TichyTech/Quadcopter/docs/AP7366_grid.jpg

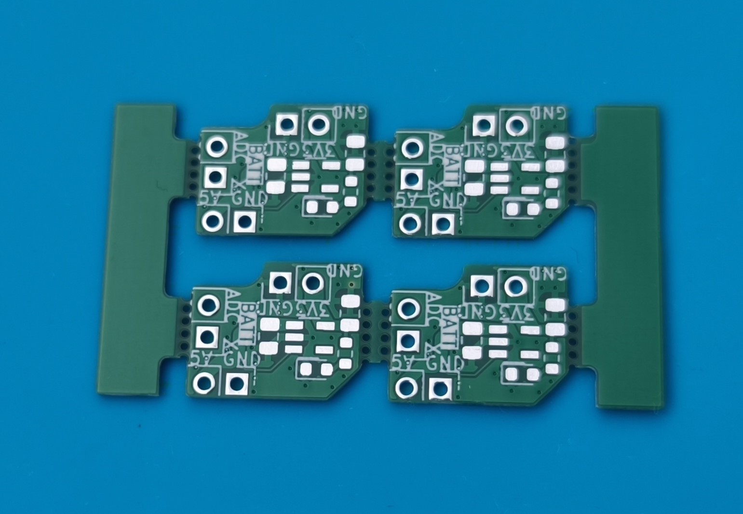
docs/AP7366_grid.jpg
