TichyTech/Quadcopter/docs/CADscreen_inside.png

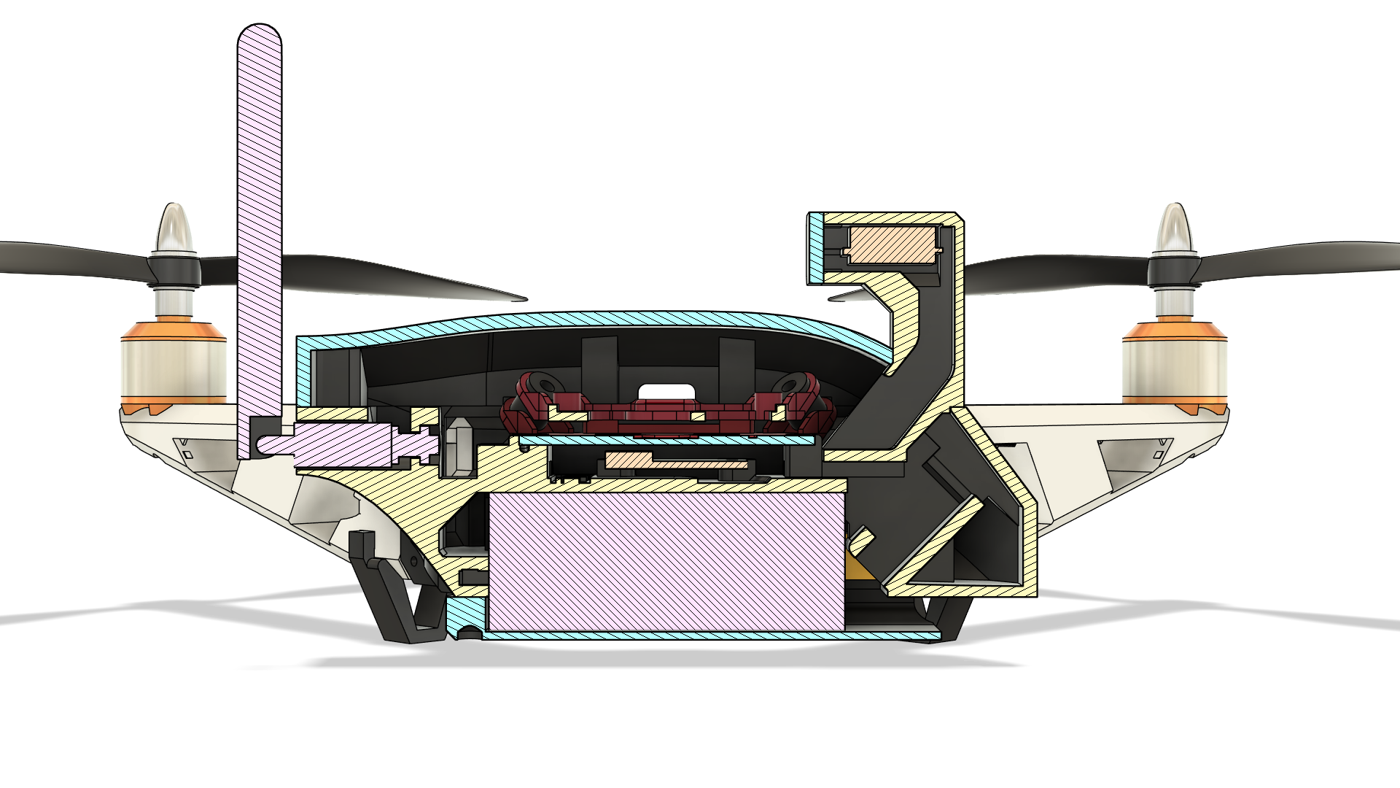
docs/CADscreen_inside.png
