TichyTech/Quadcopter/docs/FC_PCB2.jpg

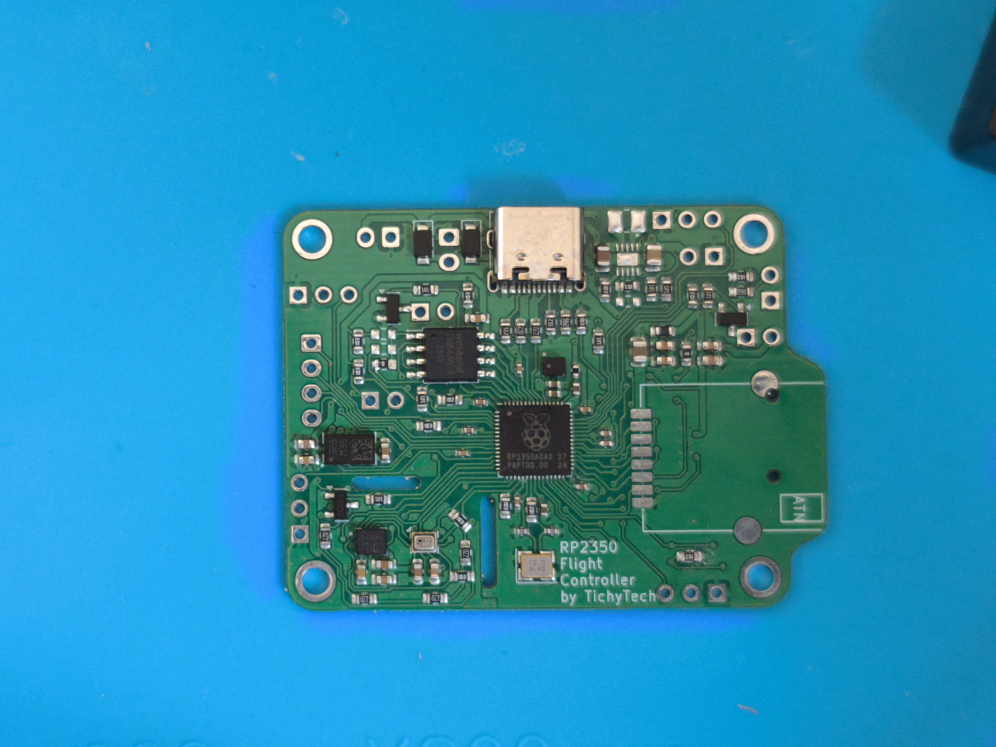
docs/FC_PCB2.jpg
