TichyTech/Quadcopter/RemoteController/src/config.h

#define PRINT_COMMANDS 0
#define DEBUG 0
#define STATE2SERIAL 1
#define HUMAN_READABLE 0  // human readable STATE2SERIAL

#define PRINT_MIN_DELAY 0

#define POT_PIN A0

#define JOYLB_PIN A1
#define JOYLX_PIN A2
#define JOYLY_PIN A3

#define JOYRX_PIN A6
#define JOYRY_PIN A7

#define BUTTON_R_PIN 2
#define BUTTON_L_PIN 3
#define SWITCH_PIN 4

#define LED1_PIN 5
#define LED2_PIN 6
#define LED3_PIN 7
#define WSLED_PIN 8
