TichyTech/Quadcopter/FlightController/include/definitions.h

#ifndef DEFS_H
#define DEFS_H

#include <BasicLinearAlgebra.h>
using namespace BLA;

// helpful commands
// #define NOP __asm__("nop");  // 0.0108 us (at pico base frequency)

/**
 * The signum function sgn(x) = -1 if x < 0, else 1
 */
template <typename T>
inline int sgn(T x){
  return x < 0 ? -1 : 1;
}

inline float max(float a, float b){
  return (a < b ? b : a);
}

// helpful constants
#define PI_F 3.14159265359f
#define TO_DEG 57.29578f
#define TO_RAD 0.01745329251f

// helpful types
using Vector3 = Matrix<3>;
using Vector4 = Matrix<4>;
using Matrix3 = Matrix<3, 3>;
using Matrix4 = Matrix<4, 4>;

const Eye<3, 3> I_3;
const Eye<4, 4> I_4;
const Eye<6, 6> I_6;
const Eye<7, 7> I_7;
const Eye<10, 10> I_10;

const Vector4 zero_4vector = {0,0,0,0};
const Vector3 zero_3vector = {0,0,0};
const Vector4 inf_4vector = {INFINITY, INFINITY, INFINITY, INFINITY};

// Flight controller-used structures definitions

struct State{
  Vector3 pos;
  Vector3 vel;
  Vector3 rpy;
  Vector3 omega;
};

struct AttReference{
  float roll = 0;
  float pitch = 0;
  float yaw = 0;
  float throttle = 0;
  uint32_t motors_on = 0;
};

struct Measurements{
  Vector3 acc_vec;
  Vector3 mag_vec;
  Vector3 gyro_vec;
  float altimeter;
  float battery = 12;
  float integration_period;
};   // struct to hold all measured values

struct Temperatures{
  float imu_temp;
  float rp_temp;
  float alt_temp;
  float mag_temp;
};   // struct to hold all measured values

struct Parameters{
  float a;
  float b;
  float c;
  float x;
  float y;
  float z;
};   // generic parameters struct

#endif
