TichyTech/Quadcopter/(commit log)

2025-09-09 switched order
2026-05-09 chore: const correctness and comments
    [sensor_manager.cpp]
2026-05-09 fix: define methods for initializing DCM and converting DCM to RPY
    [algebra.h]
2026-05-09 chore: further const correctness, cleanup
    [NRF24.cpp, NRF24.h, comm_structs.cpp, comm_structs.h, main.cpp, mediator.h]
